anirvan95/hovercraft_id/README.md

# betahovercraft
Files for the Control and Identification of Hovercraft Semester Project at EPFL
