anirvan95/hovercraft_id/Hardware/Part Details.pdf

S.No | Part Name | Link | Dimention(mm)
1 | BETAFPV 1103 11000kv Brushless Motors | https://betafpv.com/collections/brushless-motors/products/1103-brushless-motors?variant=14762596007980
2 | BETAFPV 40mm 4-Blade Props | https://betafpv.com/collections/frames-props/products/gemfan-40mm-4-blade-propellers-1-5mm-shaft
3 | Hobbywing XRotor 12A 4IN1 1-4S Micro ESC | https://www.hobbywingdirect.com/products/xrotor-micro-4in1-12a
4 | Lipo Battery Gaoneng GNB HV 650mAh 60C - 2s | https://www.amazon.com/GAONENG-650mAh-2Packs-Longer-Toothpick/dp/B07PZ5B6K6
5 | FC - HUZZA32 Feather | https://www.adafruit.com/product/3405 | 50x22.86x5
