anirvan95/hovercraft_id/Report/Images/simulation_1.png

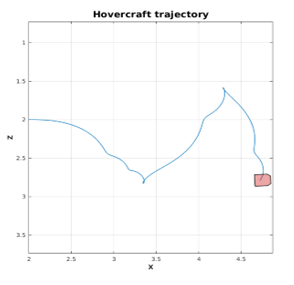
Report/Images/simulation_1.png
