anirvan95/hovercraft_id/Hardware/CAD/Complete_Assembly.STEP

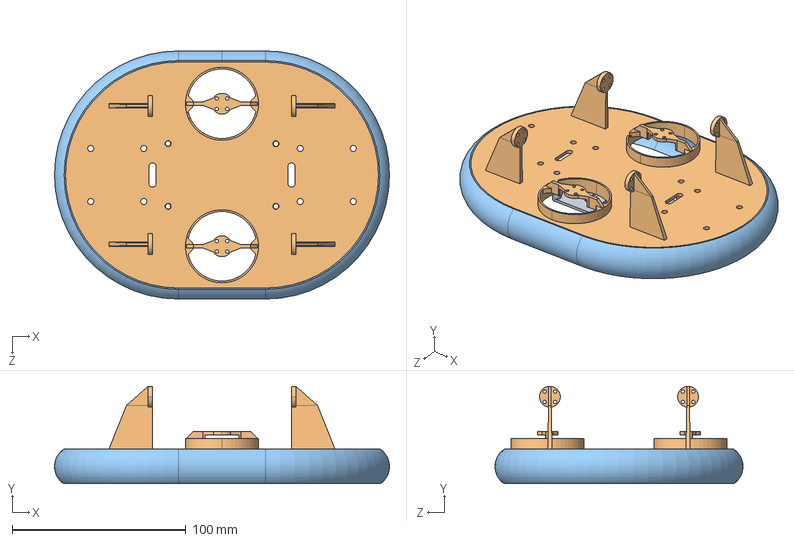
[picture p24: CAD file, 2020-01-30]
Hardware/CAD/Complete_Assembly.STEP
192.7 x 56.0 x 142.7 mm
Battery_Holder
Main_body
Skirt
