anirvan95/hovercraft_id/Hardware/CAD/Main_body.SLDPRT

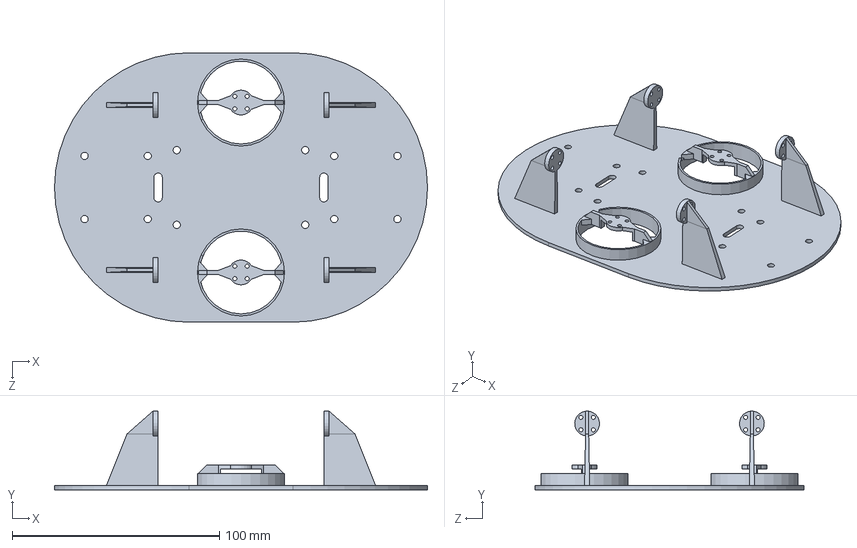
[picture p25: CAD file, 2020-01-30]
Hardware/CAD/Main_body.SLDPRT
180.0 x 38.0 x 130.0 mm
