anirvan95/hovercraft_id/Hardware/CAD/Battery_Holder.SLDPRT

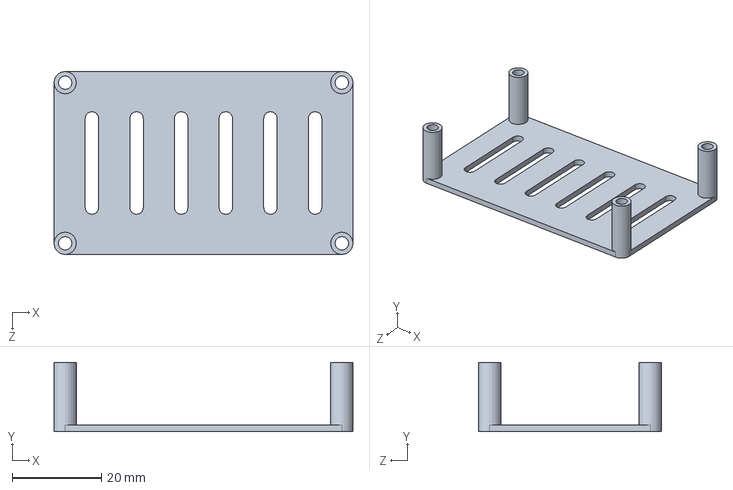
[picture p26: CAD file, 2020-01-30]
Hardware/CAD/Battery_Holder.SLDPRT
67.0 x 15.5 x 41.0 mm
