anirvan95/hovercraft_id/Hardware/CAD/Skirt_straight.STL

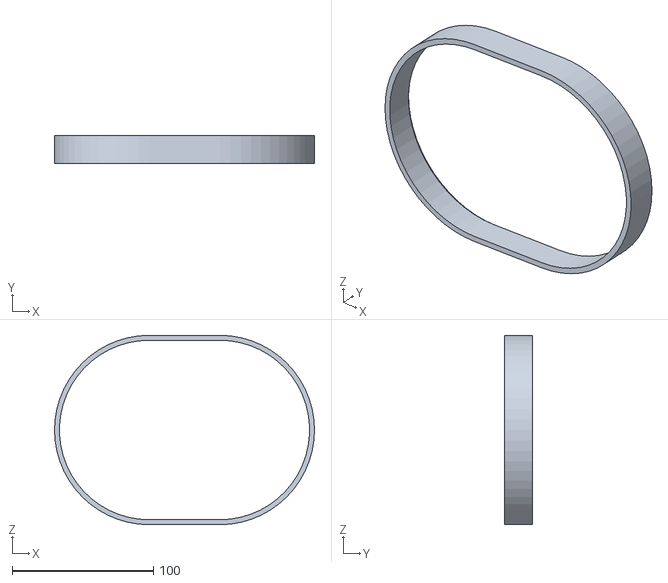
[picture p27: CAD file, 2020-01-30]
Hardware/CAD/Skirt_straight.STL
184.0 x 20.0 x 134.0
