anirvan95/hovercraft_id/Hardware/CAD/Skirt.SLDPRT

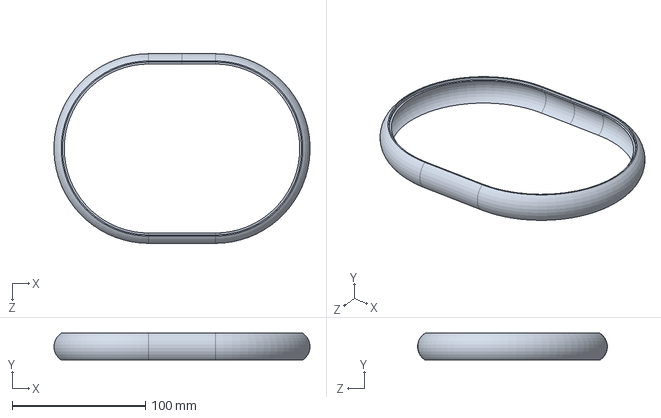
[picture p28: CAD file, 2020-01-30]
Hardware/CAD/Skirt.SLDPRT
192.4 x 20.0 x 142.6 mm
