anirvan95/hovercraft_id/(list of files, cad)

Other CAD files:
Hardware/CAD/Battery_Holder.STL
Hardware/CAD/Complete_Assembly.SLDASM
Hardware/CAD/Main_body.STL
Hardware/CAD/Skirt.STL
