anirvan95/hovercraft_id/Hardware/Proposed TinyWhooper detail_dim.pdf

µ

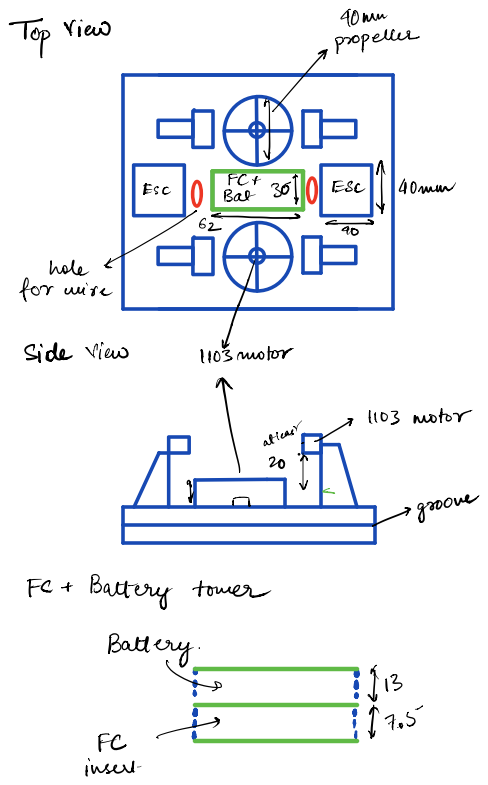
[picture p29: page 1]
Top view; due; Esc; Facet301 Esc My40mm; hole 2 for wire; side view; uofmotor; atleast I 1103 motor; groove; Batteryhis; ideas

Fct Battery tourer
insert
