anirvan95/hovercraft_id/Hardware/Proposed TinyWhopper.pdf

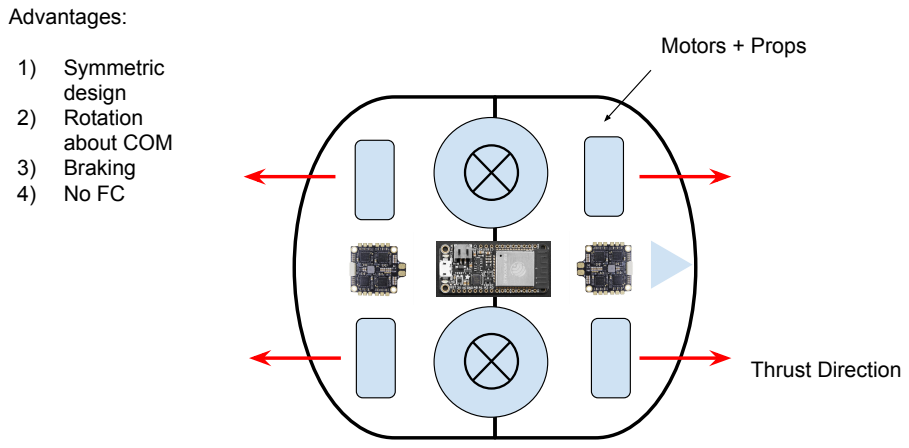
[picture p30: page 1]
Motors + Props; Thrust Direction; Advantages:; 1) Symmetric design 2) Rotation about COM 3) Braking 4) No FC
