anirvan95/hovercraft_id/Report/Images/flow.pdf

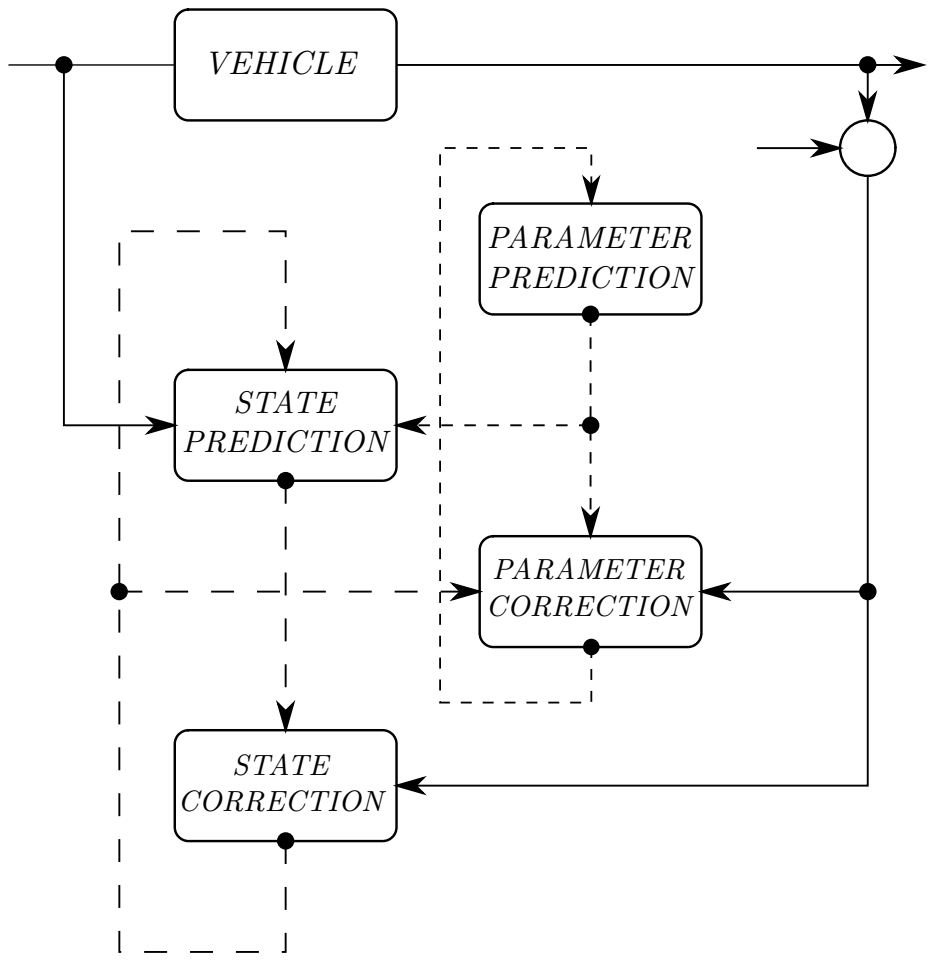
[picture p31: page 1]
VEHICLE; PARAMETER PREDICTION; STATE PREDICTION; PARAMETER CORRECTION; STATE CORRECTION
